CAt0mIcS/DeltaV/docs/architecture/electrical/electrical.tex

\section{Stepper Motor Driver}
\input{electrical/Stepper Motor Driver/stepper-motor-driver.tex}
