CAt0mIcS/DeltaV/electrical/3d-models/mosfet_irf530npbf.stp

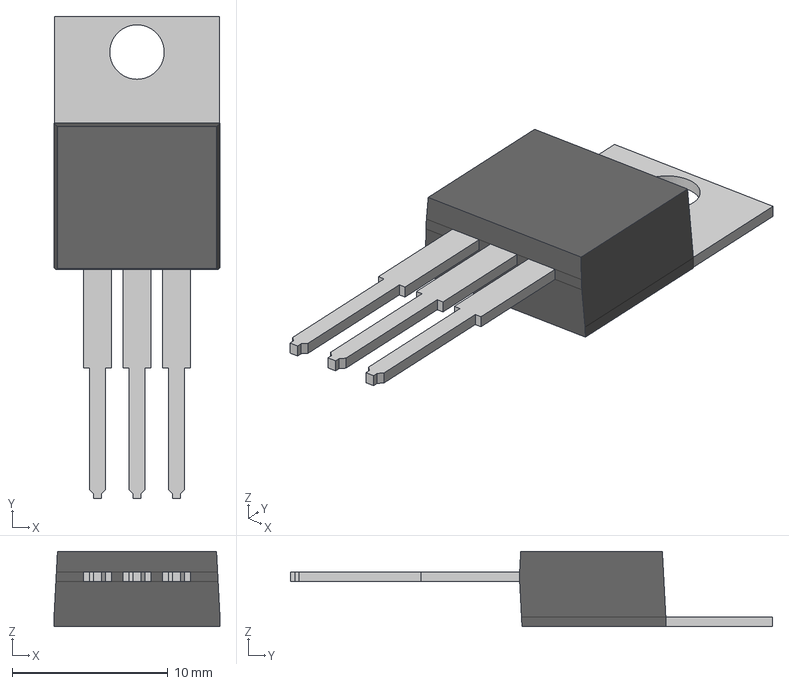
[picture p1: CAD file, 2026-10-24]
electrical/3d-models/mosfet_irf530npbf.stp
10.7 x 31.0 x 4.83 mm
