CAt0mIcS/DeltaV/mechanical/End-Effector/End-Effector Plate.SLDPRT

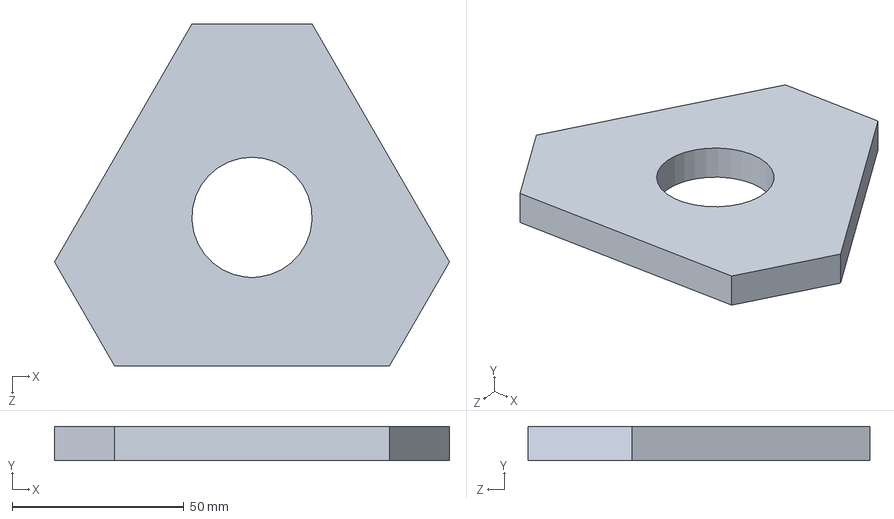
[picture p2: CAD file, 2026-08-06]
mechanical/End-Effector/End-Effector Plate.SLDPRT
115.0 x 10.0 x 99.6 mm
