CAt0mIcS/DeltaV/electrical/Stepper-Motor-Driver/circuits/Stepper Motor Driver.kicad_pcb

## KiCad design USV_pinout/usv_pinout/usv_pinout.kicad_sch

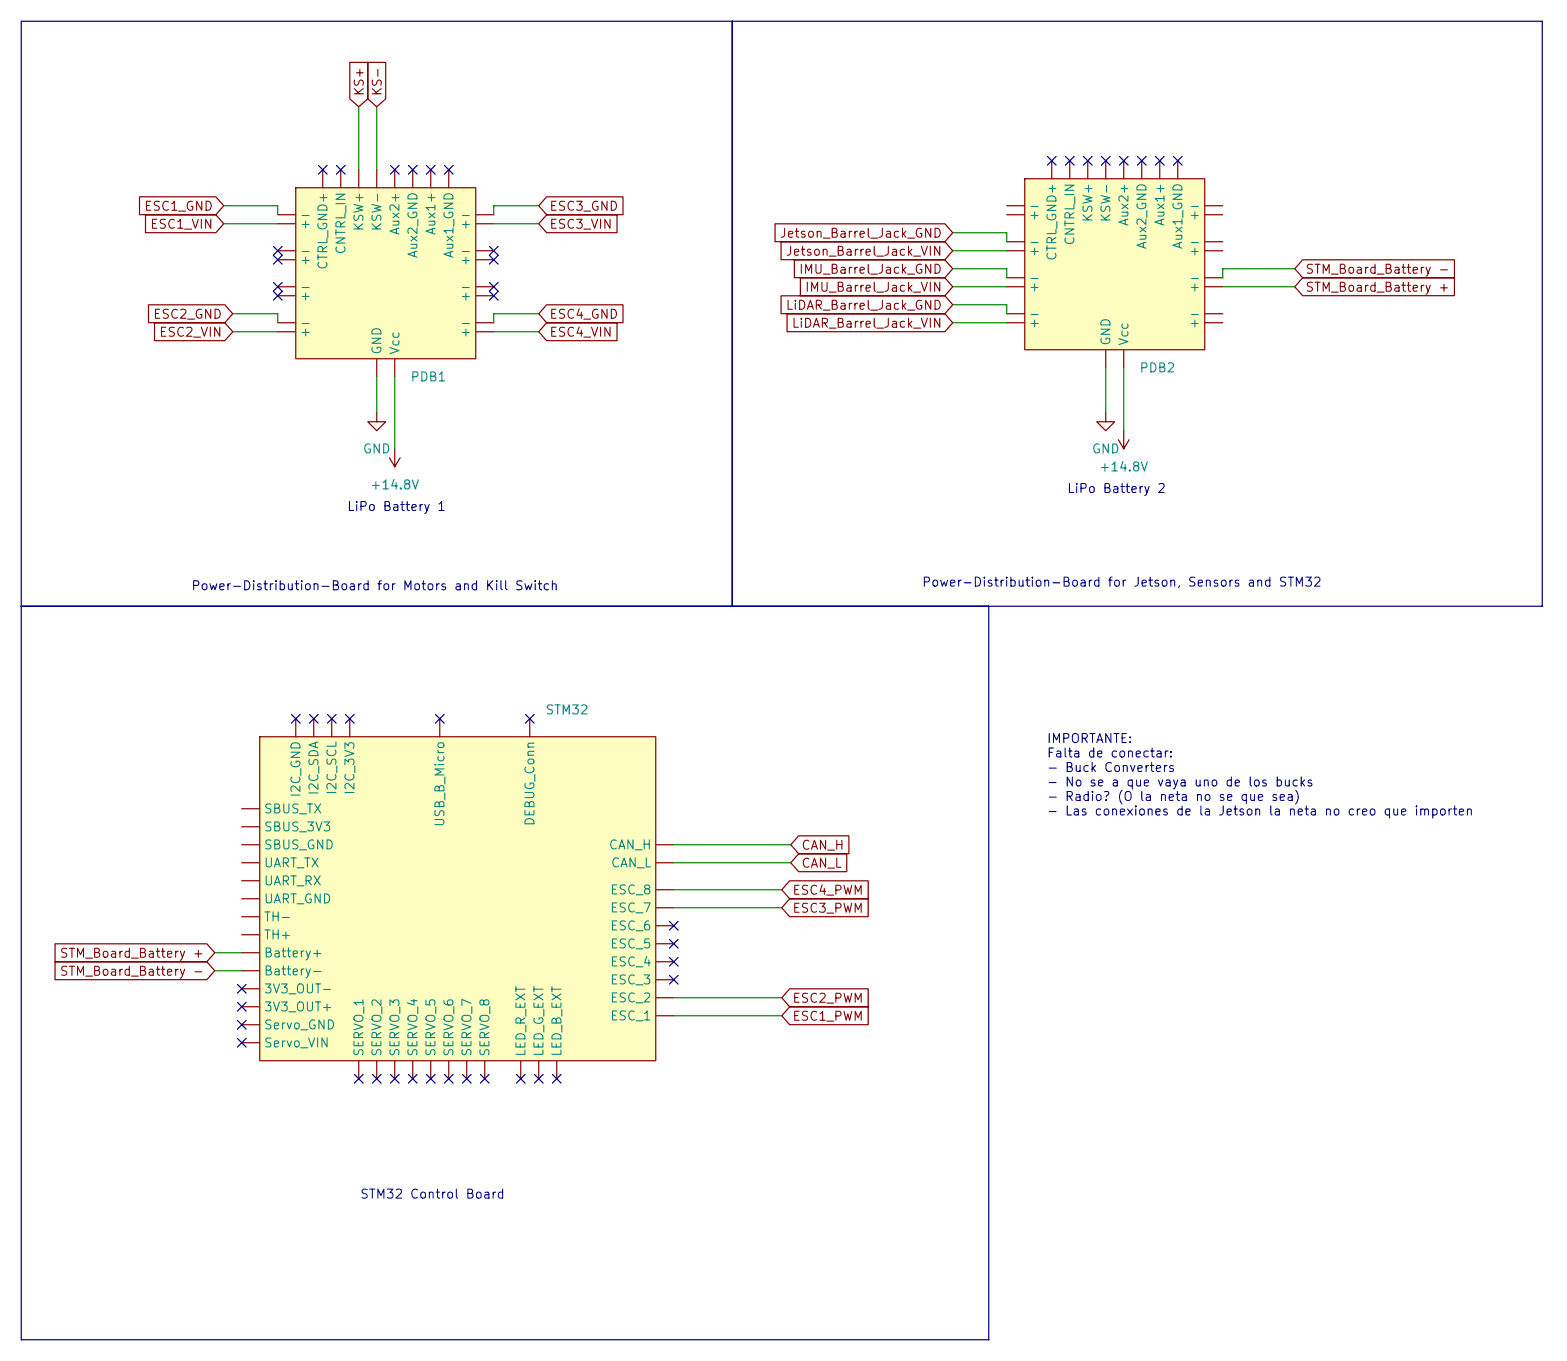
[picture p3: schematic usv_pinout.kicad_sch]

Parts:
PDB1, PDB2: (no value)
STM32: (no value)

Connections:
+14.8V: PDB1., PDB2.
CAN_H: STM32.
CAN_L: STM32.
ESC1_GND: PDB1.
ESC1_PWM: STM32.
ESC1_VIN: PDB1.
ESC2_GND: PDB1.
ESC2_PWM: STM32.
ESC2_VIN: PDB1.
ESC3_GND: PDB1.
ESC3_PWM: STM32.
ESC3_VIN: PDB1.
ESC4_GND: PDB1.
ESC4_PWM: STM32.
ESC4_VIN: PDB1.
GND: PDB1., PDB2.
IMU_Barrel_Jack_GND: PDB2.
IMU_Barrel_Jack_VIN: PDB2.
Jetson_Barrel_Jack_GND: PDB2.
Jetson_Barrel_Jack_VIN: PDB2.
KS+: PDB1.
KS-: PDB1.
LiDAR_Barrel_Jack_GND: PDB2.
LiDAR_Barrel_Jack_VIN: PDB2.
STM_Board_Battery +: PDB2., STM32.
STM_Board_Battery -: PDB2., STM32.

Notes on the sheet:
IMPORTANTE: Falta de conectar: - Buck Converters - No se a que vaya uno de los bucks - Radio? (O la neta no se que sea) - Las conexiones de la Jetson la neta no creo que importen
STM32 Control Board
LiPo Battery 2
Power-Distribution-Board for Jetson, Sensors and STM32
LiPo Battery 1
Power-Distribution-Board for Motors and Kill Switch
