CAt0mIcS/DeltaV/(commit log)

2026-08-08 Motor testing circuit
    [Testing Circuit.kicad_pcb, Testing Circuit.kicad_sch]
2026-08-08 Adding correct nMOS symbol
    [Testing Circuit.kicad_sch]
2026-08-15 Final MOSFET selection and spice models
    [Testing Circuit.kicad_sch]
2026-08-15 Adding motor spice model
    [Testing Circuit.kicad_sch]
2026-08-15 Selecting diodes and adding all recommended components
    [Testing Circuit.kicad_sch]
2026-08-18 Docs for H-Bridge + driver
    [Testing Circuit.kicad_sch]
2026-08-25 Subcircuit for stepper motor driver
    [H-Bridge Controller.kicad_sch, Half-Bridge Controller.kicad_sch, Stepper Motor Driver.kicad_pcb, Stepper Motor Driver.kicad_sch]
2026-08-25 Adding low-pass input filter
    [Stepper Motor Driver.kicad_sch]
2026-08-25 Some falstad circuit sims
2026-08-26 Correct timer configuration for timer 3
    [main.cpp]
2026-08-30 Rename folder
    [H-Bridge Controller.kicad_sch, Half-Bridge Controller.kicad_sch, Stepper Motor Driver.kicad_pcb, Stepper Motor Driver.kicad_sch, Testing Circuit.kicad_pcb, Testing Circuit.kicad_sch]
2026-09-01 Adding capacitors to reduce ringing from parasitic wire inductance
    [Testing Circuit.kicad_sch]
2026-09-03 Testing current measurements
2026-09-04 Current sensing circuit
    [Current Sensor.kicad_sch, H-Bridge Controller.kicad_sch, Half-Bridge Controller.kicad_sch, Stepper Motor Driver.kicad_sch]
2026-09-04 Through holes for FPGA
    [Stepper Motor Driver.kicad_sch]
2026-09-08 Symbol cleanup and initial power section design
    [Current Sensor.kicad_sch, Half-Bridge Controller.kicad_sch, Power.kicad_sch, Stepper Motor Driver.kicad_sch]
2026-09-09 Better buck converters and rest of power architecture
    [Power.kicad_sch, Stepper Motor Driver.kicad_sch]
2026-09-09 Fixed missing PWR_FLAG
    [Half-Bridge Controller.kicad_sch, Power.kicad_sch, Stepper Motor Driver.kicad_sch]
2026-09-09 Fixed missing connection
    [Half-Bridge Controller.kicad_sch]
2026-09-09 Adding test points and FPGA sockets
    [Current Sensor.kicad_sch, Half-Bridge Controller.kicad_sch, Power.kicad_sch, Stepper Motor Driver.kicad_sch]
2026-09-09 Adding Tang Nano 9k development board symbol and footprint
    [Stepper Motor Driver.kicad_sch]
2026-09-10 Adding pin assignment for FPGA
    [Stepper Motor Driver.kicad_sch]
2026-09-15 Initial PCB layout
    [Current Sensor.kicad_sch, H-Bridge Controller.kicad_sch, Half-Bridge Controller.kicad_sch, Power.kicad_sch, Stepper Motor Driver.kicad_pcb, Stepper Motor Driver.kicad_sch]
2026-09-15 Fixing via sizes and adding second ground plane below analog section
    [Stepper Motor Driver.kicad_pcb]
2026-09-15 Via cleanup
    [Stepper Motor Driver.kicad_pcb]
2026-09-15 Redoing FPGA pin assignment to optimize signal trace lengths
    [Stepper Motor Driver.kicad_pcb, Stepper Motor Driver.kicad_sch]
2026-09-16 Adding series termination resistors for high frequency digital signals
    [Stepper Motor Driver.kicad_pcb, Stepper Motor Driver.kicad_sch]
2026-09-17 Adding missing decoupling for FPGA 3.3V
    [Stepper Motor Driver.kicad_pcb, Stepper Motor Driver.kicad_sch]
2026-09-17 Adding MOSFET 3D model
    [Stepper Motor Driver.kicad_pcb, mosfet_irf530npbf.stp]
2026-09-18 Ensuring continuous ground plane below analog section
    [Current Sensor.kicad_sch, Stepper Motor Driver.kicad_pcb, Stepper Motor Driver.kicad_sch]
2026-09-18 Moved power section
    [Stepper Motor Driver.kicad_pcb]
2026-09-24 Compressing layout to 100mm x 100mm
    [Stepper Motor Driver.kicad_pcb, Stepper Motor Driver.kicad_sch]
2026-09-24 TestPoint allignment
    [Stepper Motor Driver.kicad_pcb]
2026-09-25 Adding fiducial marks
    [Power.kicad_sch, Stepper Motor Driver.kicad_pcb, Stepper Motor Driver.kicad_sch]
2026-10-01 Adding thermal relief pad under LDO
    [Stepper Motor Driver.kicad_pcb]
2026-10-01 Rerouting power on L4
    [Stepper Motor Driver.kicad_pcb]
2026-10-02 Optimized capacitor placement
    [Stepper Motor Driver.kicad_pcb]
